harkiret01/Nano_Drone/docs/reports/Design_Notes_handwritten.pdf

I

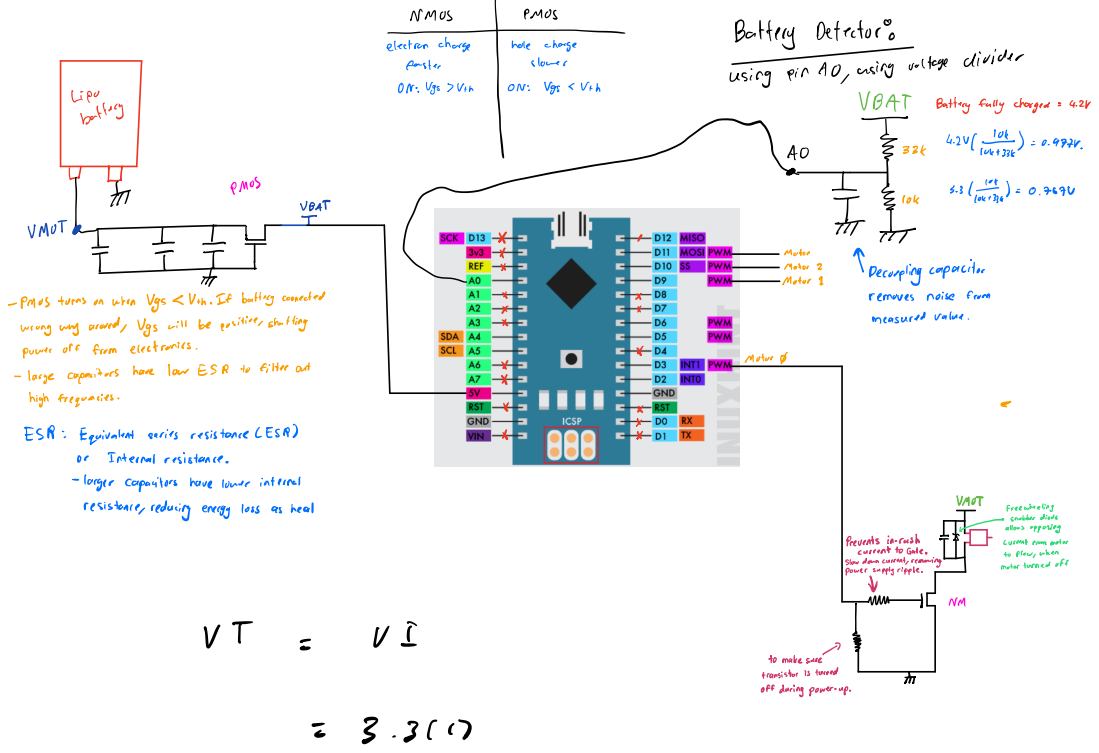
[picture p16: page 1]
faster; slower; att; test; battery; PAT; 0.977 i emos; TDecouplingcapacitor; nosturnsonwhenVgs Vin If batteryconnected; removesnoisefrom; wrongwayaround Vgswillbepositiveshutting; measuredvalue; powerorefrom electronics; motor0; highfrequencies; or Internalresistance largercapacitorshavelowerinternal; resistance; not reducingenergyloss asheal; snubberaine; currentarmmotor; agent; togate slowdowncurrentremoving; n tomakesure; transistoristurned

ESR Equivalent series resistance ESR

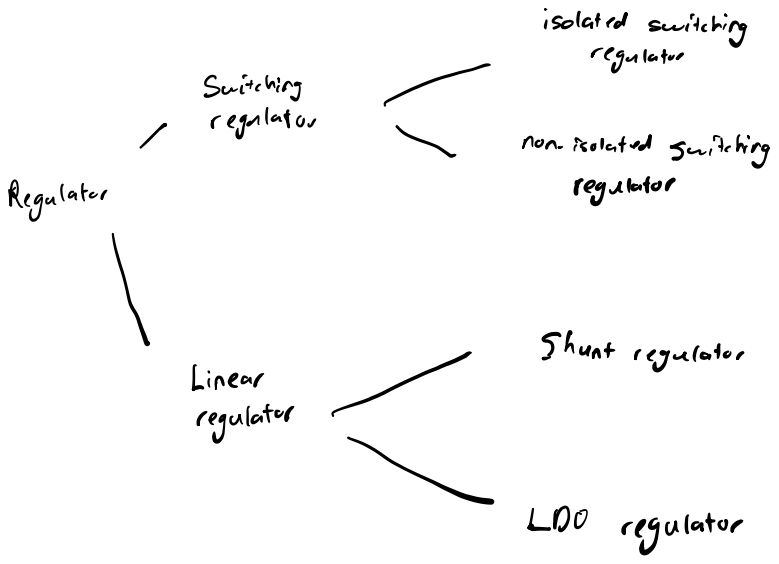
[picture p17: page 2]
isolated switching regulator; Switching; Regulator; regulator; Lpo regulator

non isolated switching

giant regulator Linear

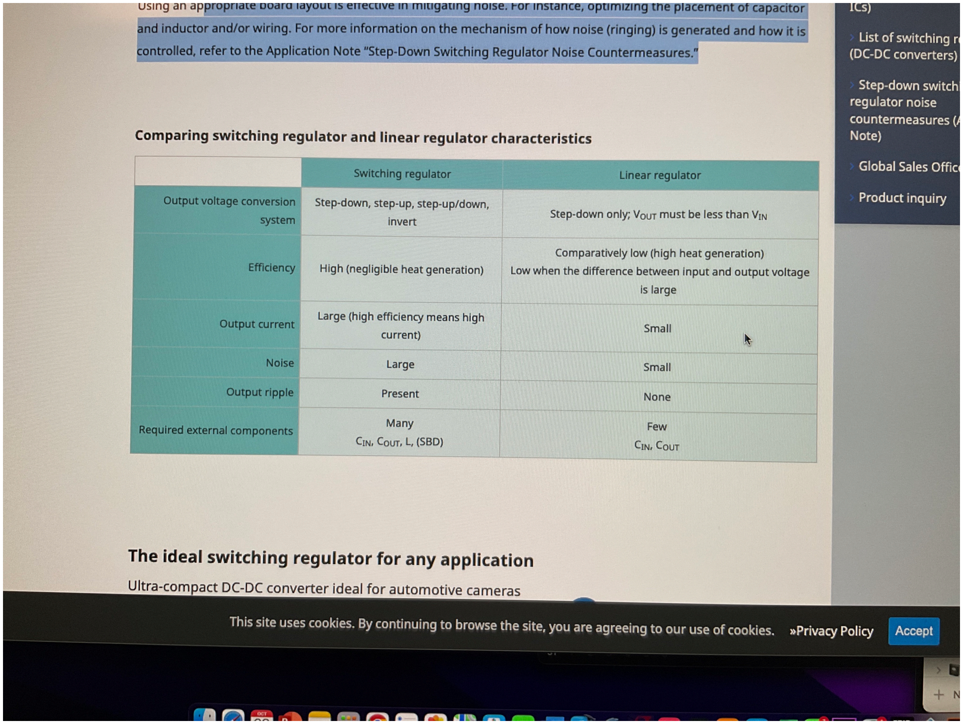
[picture p18: figure]

Coding | AO

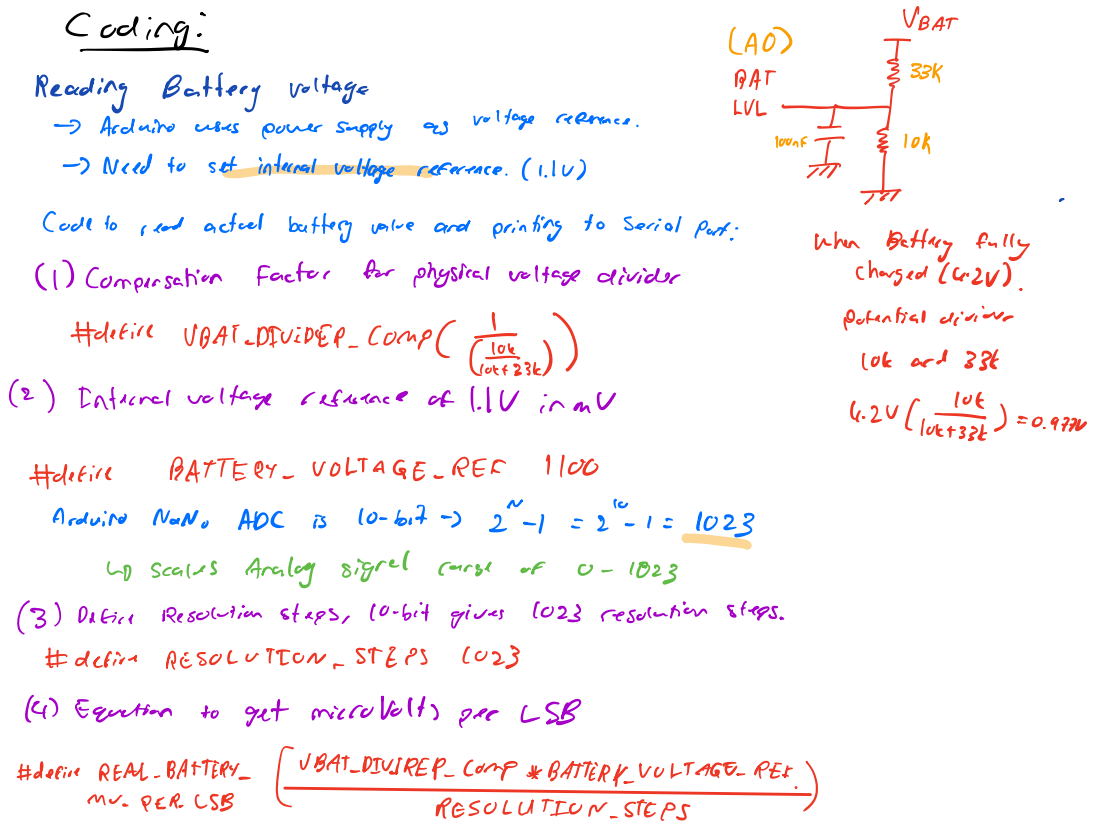
[picture p19: page 4]
Arduino uses power supply as voltage reference; Codeto read actual battery valve and printing to serial port; when Battery fully; 1 Compensation Factor for physical voltage divider; charged 6 zu; potential divider ok and 336; define BAT DIVIDER Com; Itak; 4 zu lute 0.97; Internal voltage reference of l.lv in mu; defire; BATTERY VOLTAGE REE 1100; Arduino Nano Abc is 10 bit 7 2 1; up scales Analog signal curse of; define REAL BATTERY; BATDIVIRER COMP BATTERYVOLTAGE REE; MV RER CSB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

Reading Battery voltage

3 Define Resolution steps co bit gives 1023 resolution steps
define RESOLUTION STEPS 023
4 Equation to get microvolt per LSB

Void setup s | sit only gate execute | one
sitting inter i | ti v referee

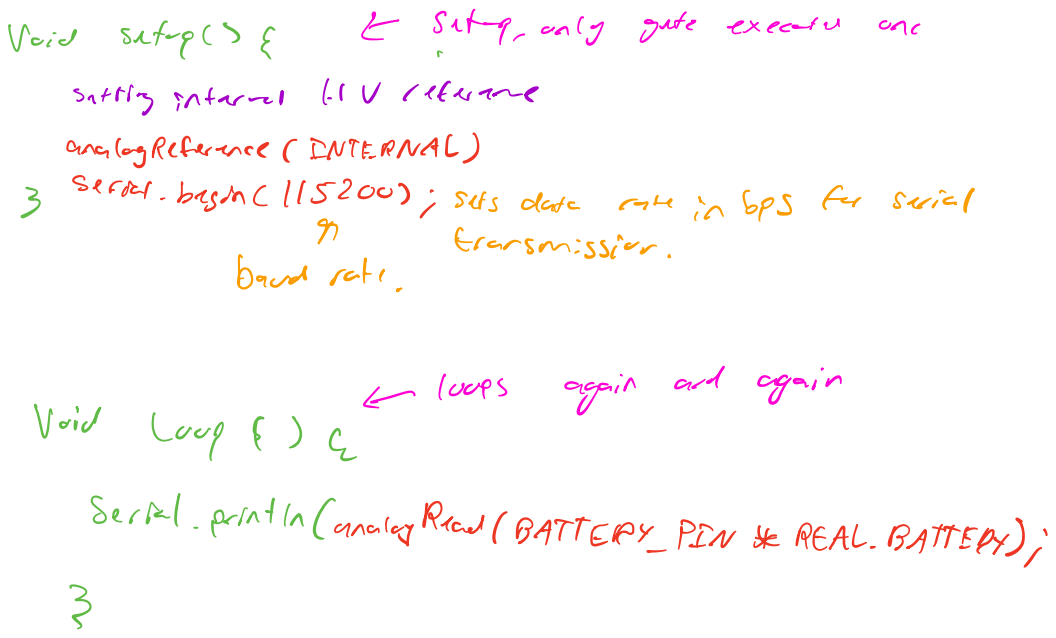
[picture p20: page 5]
analogReference INTERNAL; 3 serial begone 115200; sets data; rate in bps for serial; transmission; band rate; loves; again and again Void Loup IS a; Serial printIn analogRead BATTERY PIN; REAL BATTERY

Arduino Naro | is | co bit

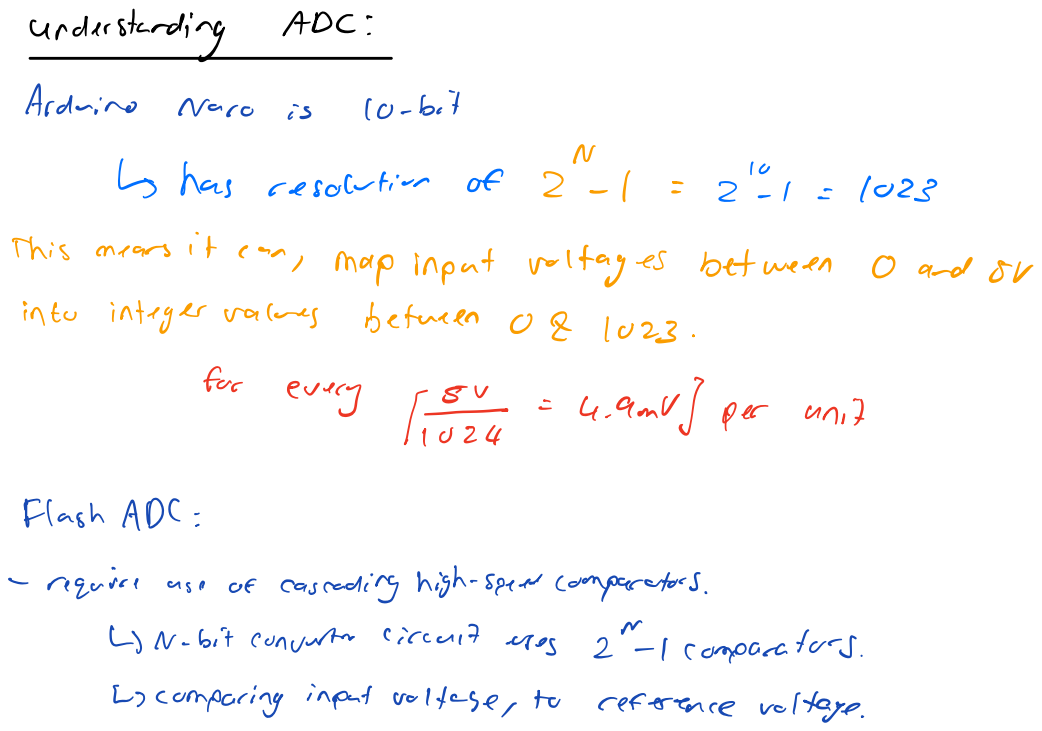
[picture p21: page 6]
understanding; ADC; has resolution; into integer values; between O Z 1023; Flash ADC; require use; of cascading high speedcomparators; comparing input voltage to; reference voltage

This means it can

map input voltages between O and JV

for
every 1,5g 4.9mV per unit

N bit convert circuit uses 211 comparators
