harkiret01/Nano_Drone/docs/reports/Nano_Drone_Presentation.pdf

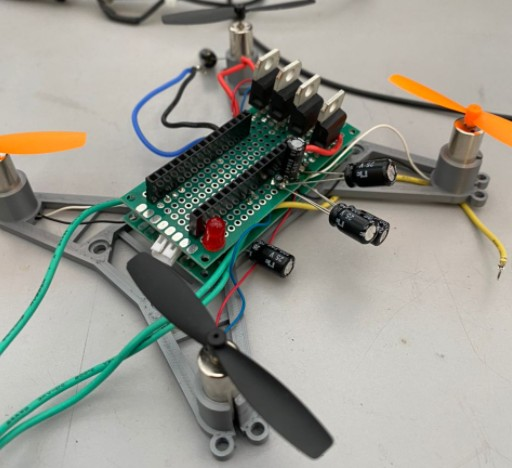
[picture p36: figure]

# Nano Drone

### Harkiret Singh

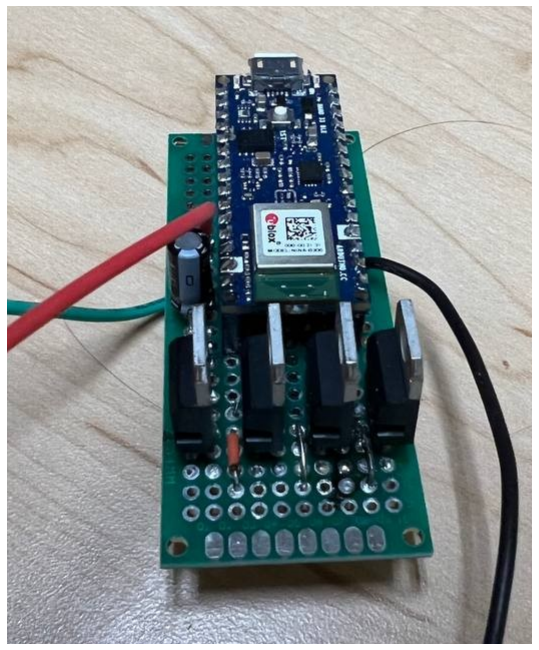
[picture p37: figure]

# Main Features:

- Reverse battery protection system
- Wireless BLE connectivity
- Battery level checker
- Stabilizing motors using a PID controller
- GYRO implementation by MPU6050

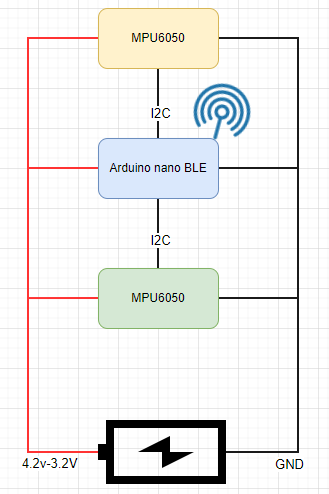
[picture p38: figure]

# Main circuit

- Ardruino Nano 33 BLE
- MPU 6050 IMU
- VL53L0X Altitude sensor
- 4.2V 650MaH Lipo battery
- 8.5mm x 20mm motors DC Brushed motors and propellors
- P-mosfets and N-Mosfets
- Capacitors, resistors and diodes

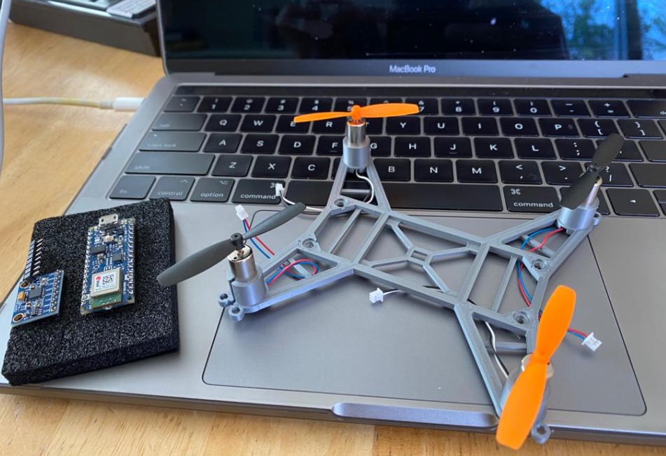
[picture p39: figure]

# Arduino nano BLE

- Has enough PWM output pins
- Has BLE connectivity module built in
- Easy to program
- Relatively small and light
- Future proof

# BLE (Bluetooth Low Energy) Connectivity

- Custom 128-bit service & characteristics
- Characteristics hold the information

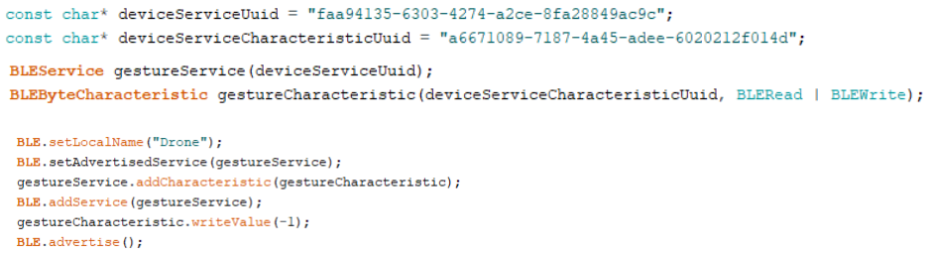
[picture p40: figure]

# BLE (Bluetooth Low Energy) Connectivity

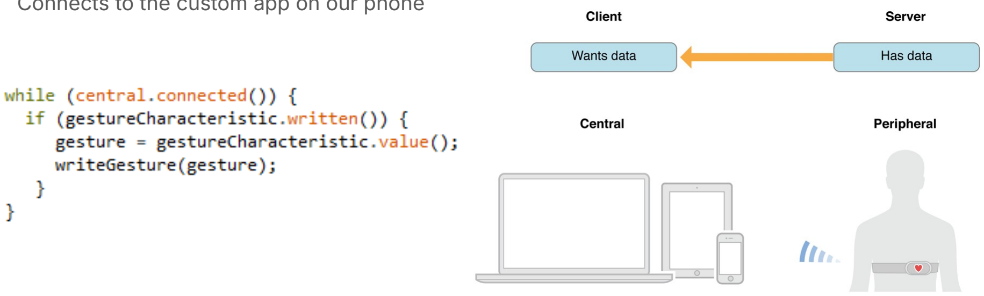
[picture p41: figure]

- Connects to the custom app on our phone

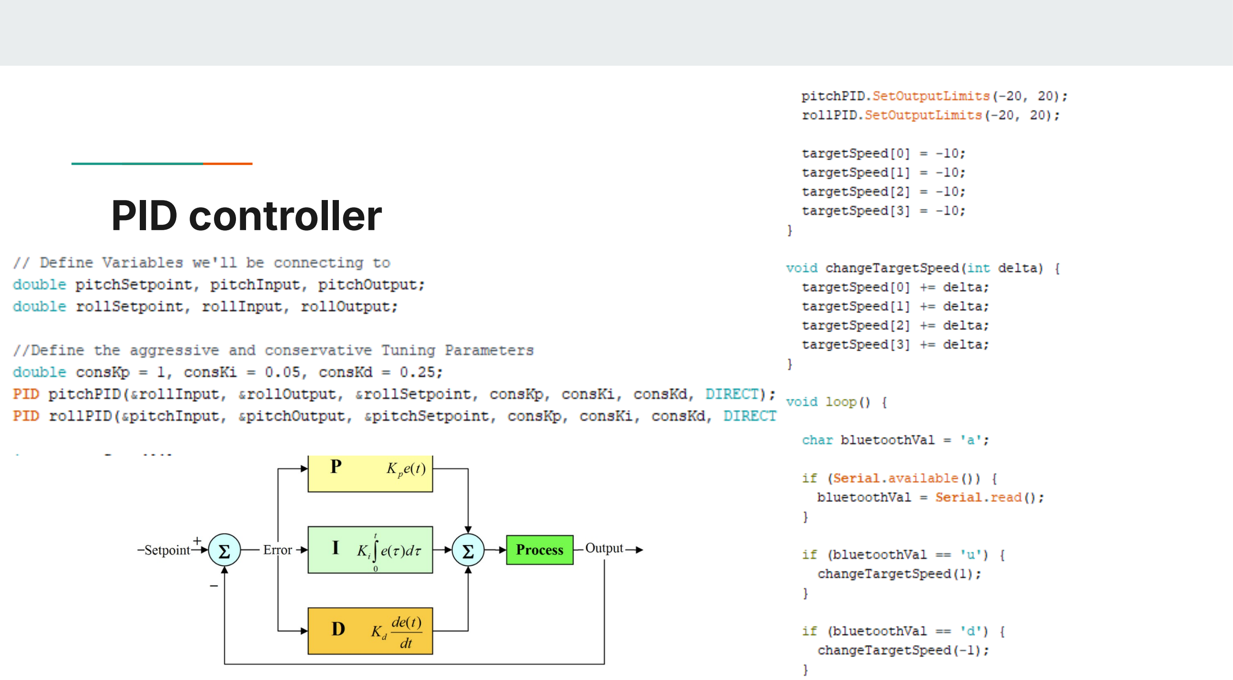
[picture p42: page 7]

# PID controller

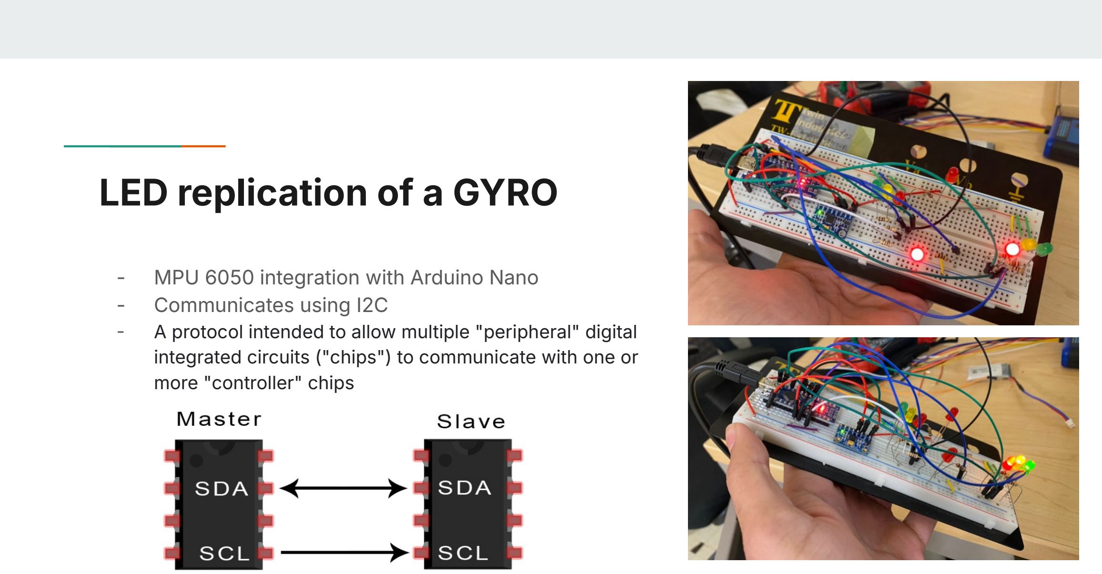
[picture p43: page 8]

# LED replication of a GYRO

- MPU 6050 integration with Arduino Nano
- Communicates using I2C
- A protocol intended to allow multiple "peripheral" digital integrated circuits ("chips") to communicate with one or more "controller" chips

# Gyroscope LED Control

- Representation of how the motors would counteract the movements
- Replicated using LED lights
- pitch/yaw for each erection
- LED’s get more bright as direction increases

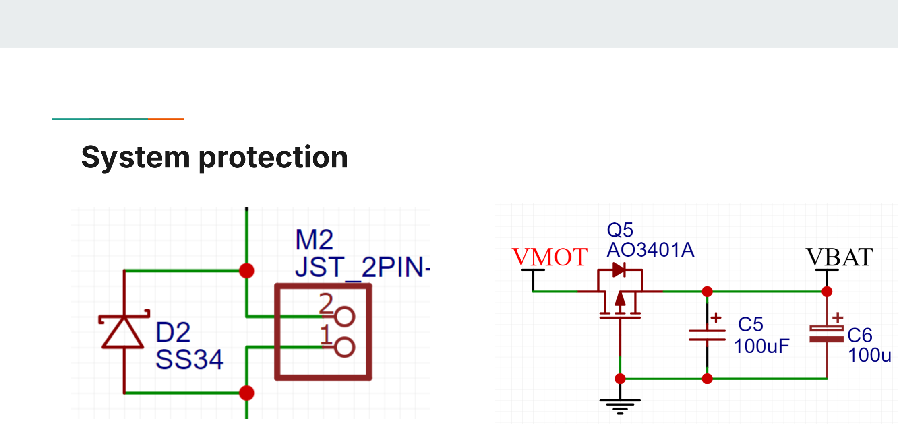
[picture p44: page 10]

# System protection

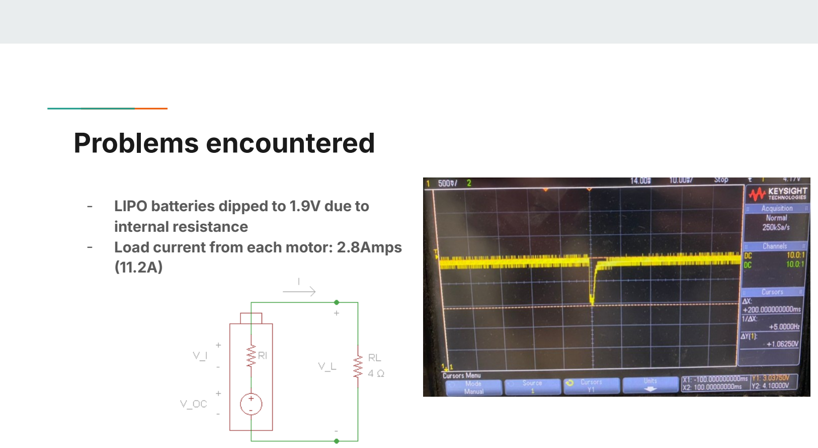
[picture p45: page 11]

# Problems encountered

- LIPO batteries dipped to 1.9V due to internal resistance
- Load current from each motor: 2.8Amps (11.2A)

# BOM

Arduino Nano 33 BLE : $27.29

Connectors & ToF sensor: $35

Battery: $20.76

Motors : $27.32

Propellors: $16.38

Components from Mouser: $20.98

Components from Protosupplies: $23.40

Components from Anchor: $13.53
