harkiret01/Nano_Drone/hardware/frame/frame_main_111x114mm.stl

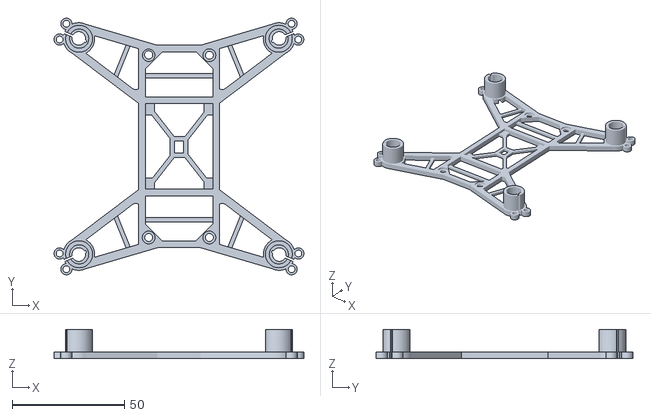
[picture p46: CAD file, 2022-05-17]
hardware/frame/frame_main_111x114mm.stl
111.1 x 114.1 x 13.0
