harkiret01/Nano_Drone/hardware/frame/mount_plate_32x86mm.stl

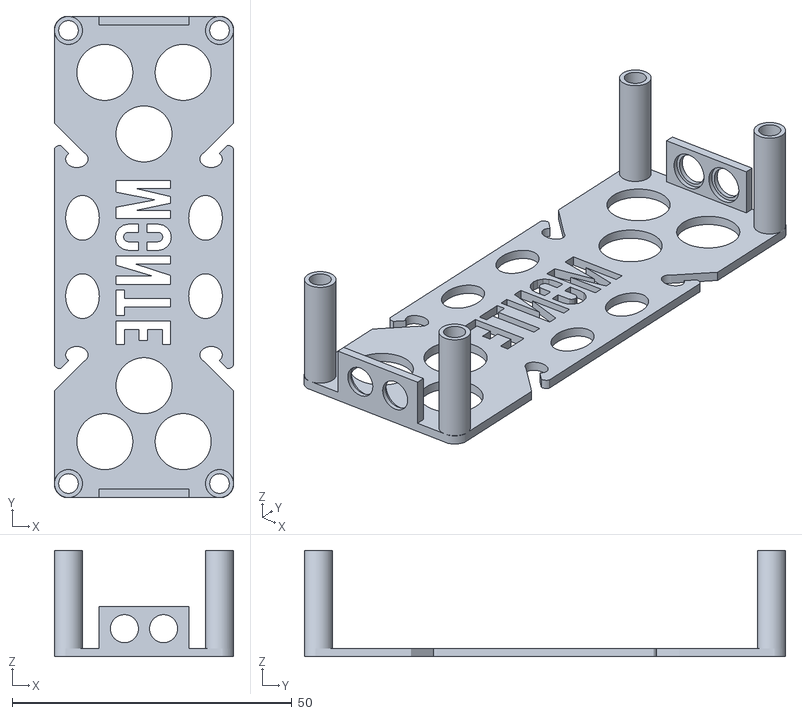
[picture p47: CAD file, 2022-05-17]
hardware/frame/mount_plate_32x86mm.stl
32.0 x 86.0 x 19.0
