harkiret01/Nano_Drone/hardware/frame/clip_24x5mm.stl

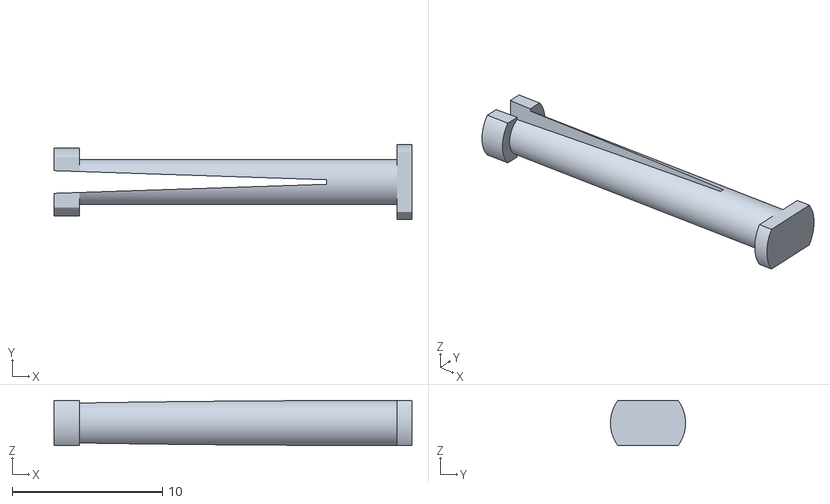
[picture p48: CAD file, 2022-05-17]
hardware/frame/clip_24x5mm.stl
23.8 x 5.00 x 3.00
