harkiret01/Nano_Drone/(list of files, cad)

Other CAD files:
hardware/frame/frame_main_prusaslicer.3mf
