harkiret01/Nano_Drone/firmware/ble_gesture_control/ble_gesture_control.ino

#include <ArduinoBLE.h>
      
enum {
  GESTURE_NONE  = -1,
  GESTURE_UP    = 48,
  GESTURE_DOWN  = 49,
  GESTURE_LEFT  = 2,
  GESTURE_RIGHT = 3
};

const char* deviceServiceUuid = "faa94135-6303-4274-a2ce-8fa28849ac9c";
const char* deviceServiceCharacteristicUuid = "a6671089-7187-4a45-adee-6020212f014d";

int gesture = -1;

BLEService gestureService(deviceServiceUuid); 
BLEByteCharacteristic gestureCharacteristic(deviceServiceCharacteristicUuid, BLERead | BLEWrite);


void setup() {
  Serial.begin(9600);
  while (!Serial);  
  
  pinMode(LEDR, OUTPUT);
  pinMode(LEDG, OUTPUT);
  pinMode(LEDB, OUTPUT);
  pinMode(LED_BUILTIN, OUTPUT);
  
  digitalWrite(LEDR, HIGH);
  digitalWrite(LEDG, HIGH);
  digitalWrite(LEDB, HIGH);
  digitalWrite(LED_BUILTIN, LOW);

  
  if (!BLE.begin()) {
    Serial.println("- Starting Bluetooth® Low Energy module failed!");
    while (1);
  }

  BLE.setLocalName("Arduino Nano 33 BLE (Peripheral)");
  BLE.setAdvertisedService(gestureService);
  gestureService.addCharacteristic(gestureCharacteristic);
  BLE.addService(gestureService);
  gestureCharacteristic.writeValue(-1);
  BLE.advertise();

  Serial.println("Nano 33 BLE (Peripheral Device)");
  Serial.println(" ");
}

void loop() {
  BLEDevice central = BLE.central();
  Serial.println("- Discovering central device...");
  delay(500);

  if (central) {
    Serial.println("* Connected to central device!");
    Serial.print("* Device MAC address: ");
    Serial.println(central.address());
    Serial.println(" ");

    while (central.connected()) {
      if (gestureCharacteristic.written()) {
         gesture = gestureCharacteristic.value();
         writeGesture(gesture);
       }
    }
    
    Serial.println("* Disconnected to central device!");
  }
}

void writeGesture(int gesture) {
  Serial.println("- Characteristic <gesture_type> has changed!");
  Serial.println(gesture);
   switch (gesture) {
      case GESTURE_UP:
        Serial.println("* Actual value: UP (red LED on)");
        Serial.println(" ");
        digitalWrite(LEDR, LOW);
        digitalWrite(LEDG, HIGH);
        digitalWrite(LEDB, HIGH);
        digitalWrite(LED_BUILTIN, LOW);
        break;
      case GESTURE_DOWN:
        Serial.println("* Actual value: DOWN (green LED on)");
        Serial.println(" ");
        digitalWrite(LEDR, HIGH);
        digitalWrite(LEDG, LOW);
        digitalWrite(LEDB, HIGH);
        digitalWrite(LED_BUILTIN, LOW);
        break;
      case GESTURE_LEFT:
        Serial.println("* Actual value: LEFT (blue LED on)");
        Serial.println(" ");
        digitalWrite(LEDR, HIGH);
        digitalWrite(LEDG, HIGH);
        digitalWrite(LEDB, LOW);
        digitalWrite(LED_BUILTIN, LOW);
        break;
      case GESTURE_RIGHT:
        Serial.println("* Actual value: RIGHT (built-in LED on)");
        Serial.println(" ");
        digitalWrite(LEDR, HIGH);
        digitalWrite(LEDG, HIGH);
        digitalWrite(LEDB, HIGH);
        digitalWrite(LED_BUILTIN, HIGH);
        break;
      default:
        digitalWrite(LEDR, HIGH);
        digitalWrite(LEDG, HIGH);
        digitalWrite(LEDB, HIGH);
        digitalWrite(LED_BUILTIN, LOW);
        break;
    }      
}
